joshjowen/smart-desk/hardware/smart-desk-case.stl

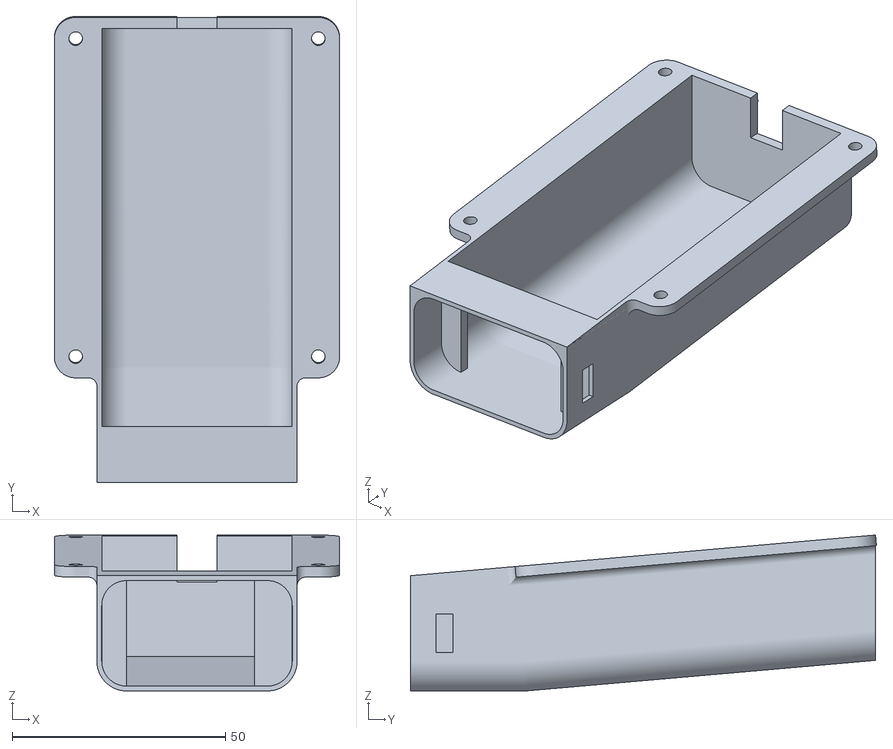
[picture p1: CAD file, 2026-11-08]
hardware/smart-desk-case.stl
66.9 x 109.3 x 36.6
