joshjowen/smart-desk/(commit log)

2026-11-05 Stage 0: prototype GUI with simulated desk
    Display (JD9853), touch (AXS5106L) and LVGL 9 bring-up, lock and control
    screens, simulated motion controller with safety invariants and duty ledger,
    serial console.
    [partitions.csv]
2026-11-05 Stage 0: fix touch (poll instead of INT) and switch UI to landscape
    [board.c, board_config.h, esp_lcd_touch_axs5106.c]
2026-11-05 Stage 1 (WIP, untested on hardware): Wi-Fi, settings, web UI, OTA
    Code complete and building; not yet flashed because the board dropped off USB.
    Adds config (NVS), net (STA + setup AP, captive DNS, mDNS, SNTP), web
    (REST, WebSocket live control, OTA with rollback), the web app, CLAUDE.md
    and tools/serlog.py.
2026-11-05 Stage 1: Wi-Fi, settings, web UI and OTA, tested on hardware
    Setup AP with captive portal, mDNS, SNTP (DHCP / gateway / pool), versioned
    settings with migration, web app with live control, REST API, WebSocket,
    admin password, OTA with rollback. Fixes found while testing: tappable Wi-Fi
    scan list, WebSocket post-handshake hook for IDF 5.5, stop-on-close tracking,
    explicit SNTP start, configurable time server.
    [console.c]
2026-11-05 Stage 2: drive the desk through the optos, hold-to-run only
    Source-mode outputs forced off first thing at boot and in the panic handler,
    presets disabled until calibration, optional handset sense, bench test docs.
    Tested on the desk.
2026-11-06 Stage 3: VL53L0X height sensor with raw readings, tested on the desk
    - vl53l0x component: Pololu-derived register driver (ST init, SPAD and
    reference calibration), continuous ranging, non-blocking sample reads.
    - height component: sensor task, median-5 + EMA filter, 500 ms validity,
    60 s history, offline detection and re-init with back-off.
    - Settings v3: ranging profile (50/200 ms) and EMA alpha, applied live.
    - Shared I2C bus mutex. Fix: a failed touch read aborted the firmware
    (esp_lvgl_port), so a sensor wiring fault boot-looped the board; touch
    errors now read as "not touched". Boot scan bails out on a stuck bus.
    - Display: sensor line on the main screens, debug screen on long p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
    [board.c, console.c, height.c, height.h]
2026-11-06 Stage 4: calibration routine, tested on the desk
    - calib.c in motion: budget check (waits, then opens the prompt by
    itself), probe for the sign, top stop, 2 coast tests down, bottom
    stop, 2 coast tests up, back to the bottom (repeatability check),
    tape-measure entry, summary, Save / Discard. Runs under every invariant;
    long runs are cut into <= 20 s segments. Order changed from the spec to
    fit the duty budget (~75 s motor time, ~80 s wall time on this desk).
    - Height model h_min + sign * scale * (reading - raw_min); calibrated
    range and max move time (travel / slowest speed x 1.3). Stored in NVS
    (record v2; v1 loads with scale 1). Presets still off until stage 5.
    - Addition: "C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
2026-11-06 Stage 5: presets with coast compensation, tested on the desk
    - Seeks release early by the learned coast + 2 mm, settle, make at most
    one correction pulse and report the final height and error. Refused
    when uncalibrated, cooling down, faulted, sensor invalid, budget low or
    out of range.
    - Coast learning (EMA 0.2, bounded to +/-50 % of the calibrated value,
    persisted at most hourly, reset by a new calibration).
    - Invariant 6: stall check for JOG and SEEK (FAULT; a jog into an end
    stop just stops), plausibility check and lost reading for seeks (FAULT).
    - Display: presets enabled, long press saves the current height, landing
    message. Web: presets enabled, "Here" per preset row, landi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
    [main.c, motion.c, motion.h]
2026-11-06 Stage 6: MQTT and Home Assistant discovery, tested with HA
    - mqtt_ha: esp-mqtt client with last will, reconnect back-off 1-60 s
    (and an immediate retry when Wi-Fi comes back), optional TLS CA or
    the CA bundle for mqtts://.
    - Retained state JSON (2 Hz moving, on change, 60 s keep-alive) and HA
    discovery: height, target height, preset buttons, stop, state, moving,
    fault, duty budget, remote moves allowed, last error. Republished on
    HA restart and when presets or calibration change.
    - Commands: stop always; preset / goto need "Allow remote moves", one
    per 2 s, no jog, and start after an on-screen countdown (0-10 s,
    default 3) held in motion; a tap or STOP cancels.
    - Display MQTT i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
    [main.c, motion.c, motion.h]
2026-11-08 Add wiring diagram, parts list and case model
    README now shows the wiring diagram, a parts list and the handset cable
    pinout above the pin table, and links the 3D-printable case STL.
    Claude-Session: https://claude.ai/code/session_011qpvVekD5KTcjjj7yB7toN
    [smart-desk-case.stl]
